ymkn/minimap/image/README.md

# 恒久的な画像

公開用写真、レイアウト図、組立説明図など、継続して参照する画像を置く。作業時のスクリーンショット・レビュー画像は `archive/image/` へ保管し、ここには置かない。現在、恒久画像は未登録。
