ymkn/minimap/FreeCAD/concepts/picture-frame/preview-top.png

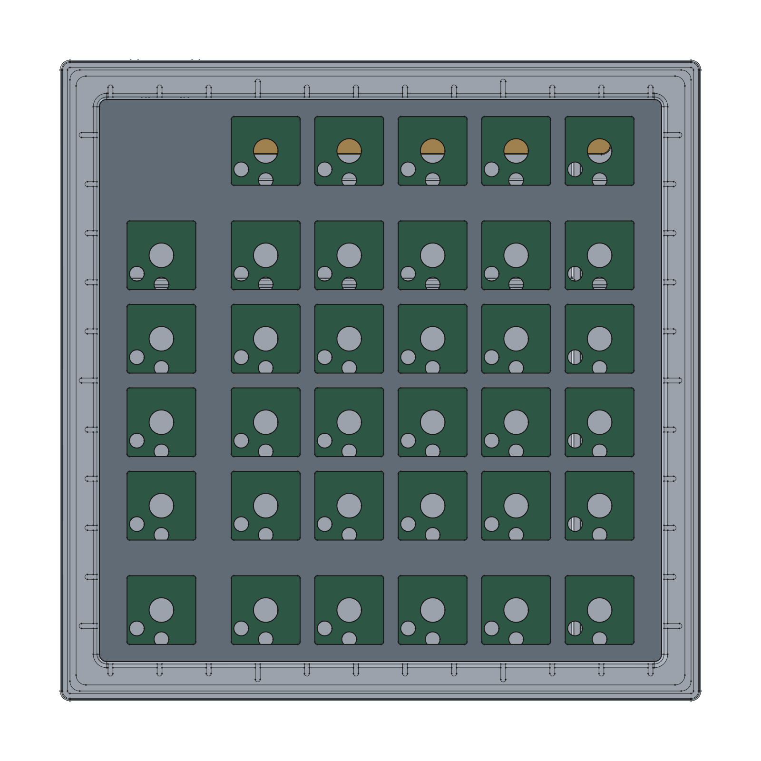
FreeCAD/concepts/picture-frame/preview-top.png
