ymkn/minimap/FreeCAD/concepts/picture-frame/minimap_frame_case.step

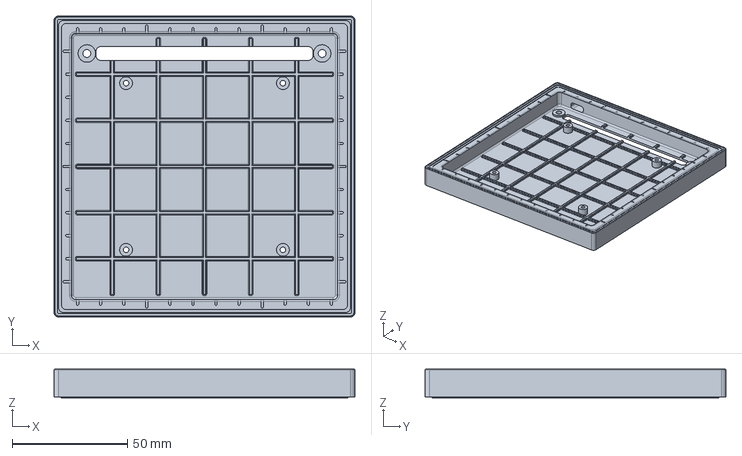
[picture p3: CAD file, 2026-11-08]
FreeCAD/concepts/picture-frame/minimap_frame_case.step
130.5 x 130.5 x 12.4 mm
