ymkn/minimap/FreeCAD/minimap.FCStd

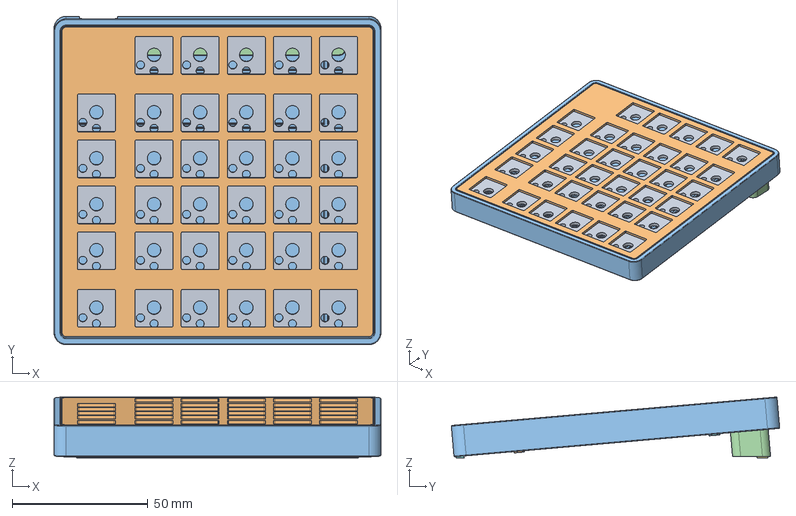
[picture p4: CAD file, 2026-11-03]
FreeCAD/minimap.FCStd
120.5 x 121.0 x 22.4 mm
Bare PCB reference - nominal 1.6mm
Choc plate reference - legacy Z10.4, actual seating UNVERIFIED
MP1 nominal M2 nut - thread omitted
MP2 nominal M2 nut - thread omitted
MP3 nominal M2 nut - thread omitted
MP4 nominal M2 nut - thread omitted
PCB M2x8 D4/H0.5 reference - 1.5mm engagement UNVERIFIED
PCB M2x8 D4/H0.5 reference - 1.5mm engagement UNVERIFIED001
PCB M2x8 D4/H0.5 reference - 1.5mm engagement UNVERIFIED002
PCB M2x8 D4/H0.5 reference - 1.5mm engagement UNVERIFIED003
Case - narrow rear opening / all original PCB mounts retained
Rear metal strip - nominal M3 taps
M3x6 D5.5/H2 low-head envelope - UNVERIFIED
M3x6 D5.5/H2 low-head envelope - UNVERIFIED001
2x rear 10x4x0.6mm rubber reference pads
104x3mm tapered elastomer reference - case front edge support
