ymkn/minimap/FreeCAD/STEP/minimap_weight_metal.step

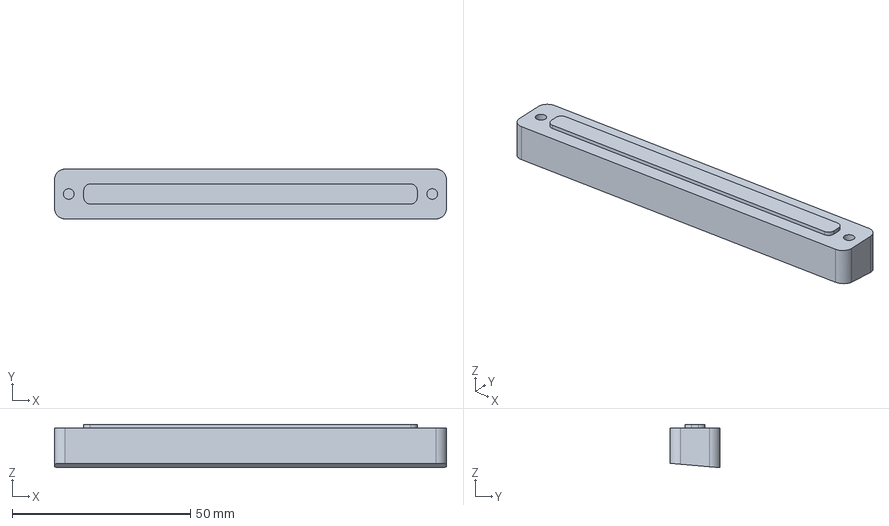
[picture p7: CAD file, 2026-11-03]
FreeCAD/STEP/minimap_weight_metal.step
110.0 x 14.0 x 12.2 mm
