ymkn/minimap/FreeCAD/STEP/minimap_case.step

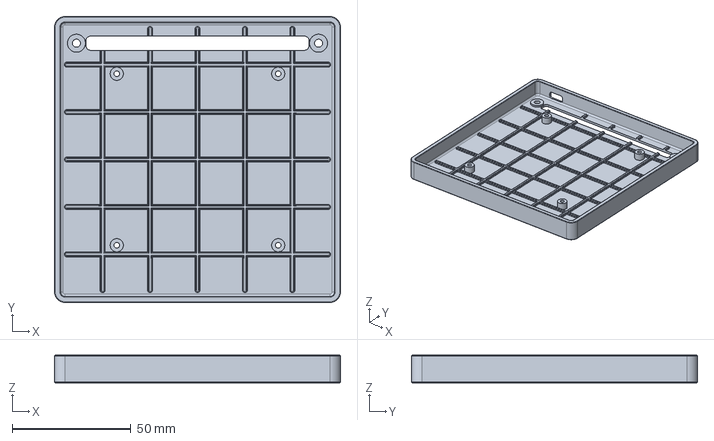
[picture p8: CAD file, 2026-11-03]
FreeCAD/STEP/minimap_case.step
120.5 x 120.5 x 11.6 mm
