ymkn/minimap/KiCAD/PCB_GLP/minimap_PCB.kicad_pcb

## KiCad design KiCAD/PCB_GLP/minimap_PCB.kicad_pcb (2026-11-03)

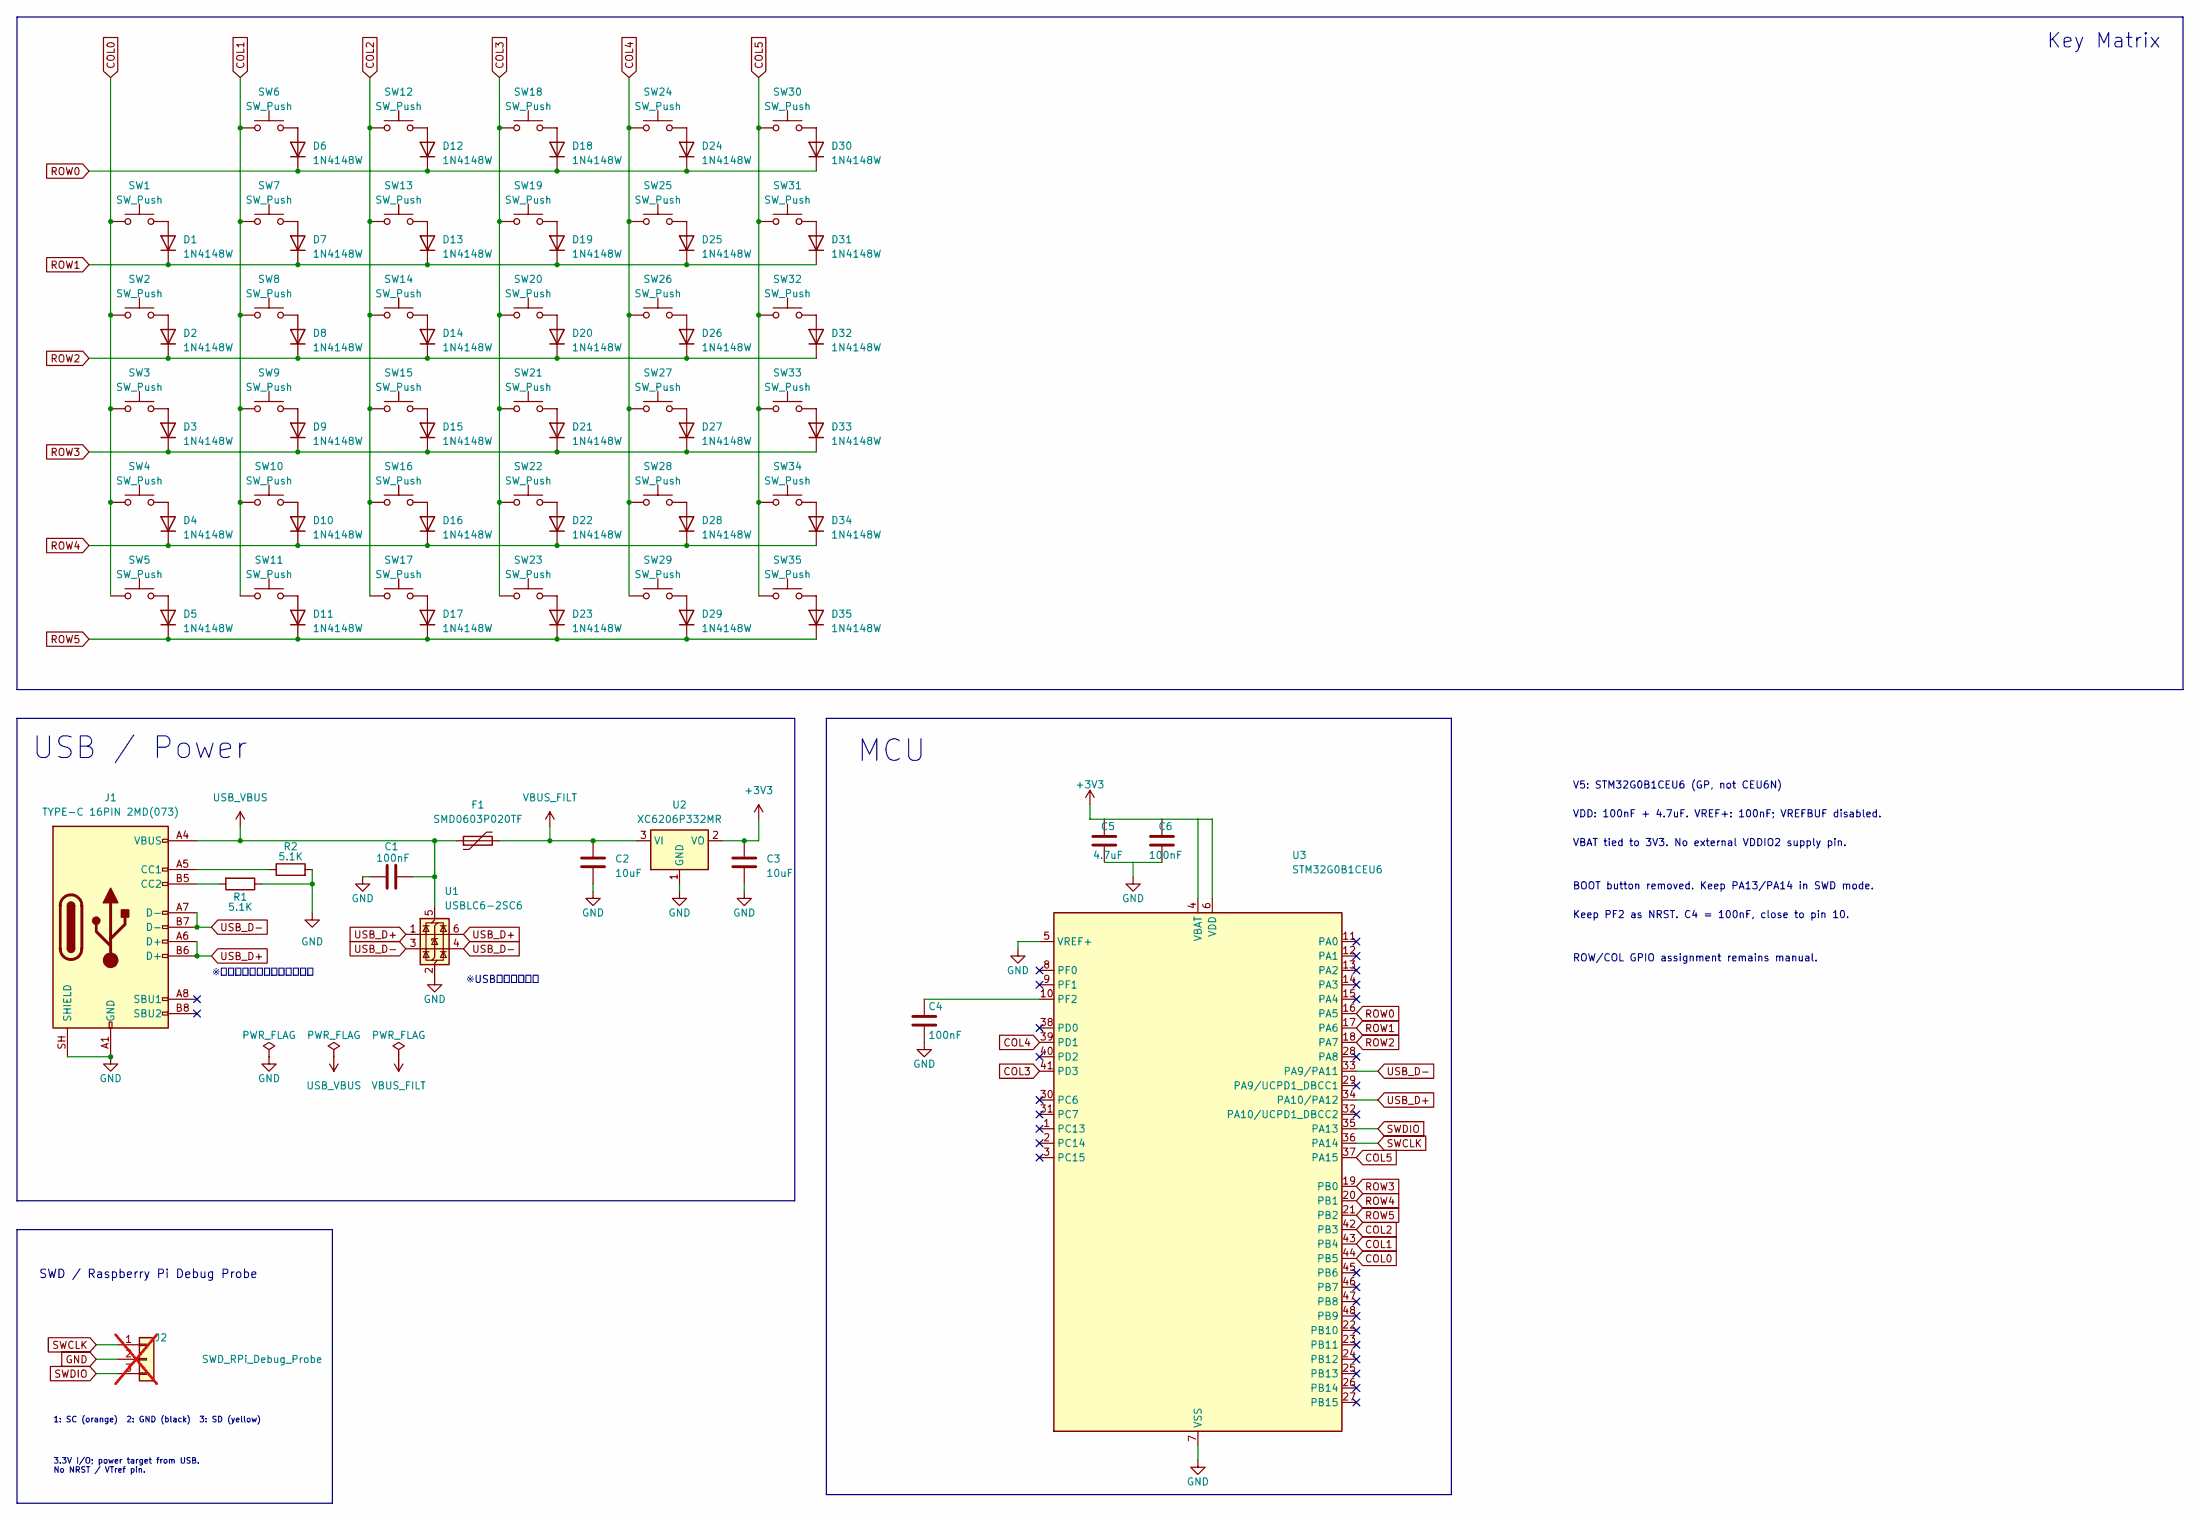
[picture p9: schematic minimap_PCB.kicad_sch, minimap - wired keyboard]

Parts:
C1, C4, C6: 100nF; C_0402_1005Metric; JLCPCB Part # C1525
C2, C3: 10uF; C_0603_1608Metric; JLCPCB Part # C19702
C5: 4.7uF; C_0402_1005Metric; JLCPCB Part # C23733
D1, D2, D3, D4, D5, D6, D7, D8, D9, D10, D11, D12, D13, D14, D15, D16, D17, D18, D19, D20, D21, D22, D23, D24, D25, D26, D27, D28, D29, D30, D31, D32, D33, D34, D35: 1N4148W; D_SOD-123; LCSC Parts # C81598
F1: SMD0603P020TF; Fuse_0603_1608Metric; JLCPCB Part # C20785
J1: TYPE-C 16PIN 2MD(073); USB_C_Receptacle_HRO_TYPE-C-31-M-12; JLCPCB Part # C2765186
J2: SWD_RPi_Debug_Probe; SWD_1x03_PlatedHoles_P2.54mm_D1.0mm; not fitted
R1, R2: 5.1K; R_0402_1005Metric; JLCPCB Part # C25905
SW1, SW2, SW3, SW4, SW5, SW6, SW7, SW8, SW9, SW10, SW11, SW12, SW13, SW14, SW15, SW16, SW17, SW18, SW19, SW20, SW21, SW22, SW23, SW24, SW25, SW26, SW27, SW28, SW29, SW30, SW31, SW32, SW33, SW34, SW35: SW_Push; SW_MX_GLP3_1u; LCSC Parts # C5333465
U1: USBLC6-2SC6; SOT-23-6; JLCPCB Part # C7519
U2: XC6206P332MR; SOT-23-3; JLCPCB Part # C5446
U3: STM32G0B1CEU6; QFN-48-1EP_7x7mm_P0.5mm_EP5.6x5.6mm; JLCPCB Part # C2829190

Connections:
+3V3: C3.1, C5.1, C6.1, U2.2 (VO), U3.4 (VBAT), U3.6 (VDD)
COL0: SW1.1, SW2.1, SW3.1, SW4.1, SW5.1, U3.44 (PB5)
COL1: SW6.1, SW7.1, SW8.1, SW9.1, SW10.1, SW11.1, U3.43 (PB4)
COL2: SW12.1, SW13.1, SW14.1, SW15.1, SW16.1, SW17.1, U3.42 (PB3)
COL3: SW18.1, SW19.1, SW20.1, SW21.1, SW22.1, SW23.1, U3.41 (PD3)
COL4: SW24.1, SW25.1, SW26.1, SW27.1, SW28.1, SW29.1, U3.39 (PD1)
COL5: SW30.1, SW31.1, SW32.1, SW33.1, SW34.1, SW35.1, U3.37 (PA15)
GND: C1.2, C2.2, C3.2, C4.2, C5.2, C6.2, J1.A1 (GND), J1.A12 (GND), J1.B1 (GND), J1.B12 (GND), J1.SH (SHIELD), J2.2, R1.1, R2.2, U1.2 (GND), U2.1 (GND), U3.5 (VREF+), U3.7 (VSS), U3.49 (VSS)
unnamed: D1.2 (A), SW1.2
unnamed: D2.2 (A), SW2.2
unnamed: D3.2 (A), SW3.2
unnamed: D4.2 (A), SW4.2
unnamed: D5.2 (A), SW5.2
unnamed: D6.2 (A), SW6.2
unnamed: D7.2 (A), SW7.2
unnamed: D8.2 (A), SW8.2
unnamed: D9.2 (A), SW9.2
unnamed: D10.2 (A), SW10.2
unnamed: D11.2 (A), SW11.2
unnamed: D12.2 (A), SW12.2
unnamed: D13.2 (A), SW13.2
unnamed: D14.2 (A), SW14.2
unnamed: D15.2 (A), SW15.2
unnamed: D16.2 (A), SW16.2
unnamed: D17.2 (A), SW17.2
unnamed: D18.2 (A), SW18.2
unnamed: D19.2 (A), SW19.2
unnamed: D20.2 (A), SW20.2
unnamed: D21.2 (A), SW21.2
unnamed: D22.2 (A), SW22.2
unnamed: D23.2 (A), SW23.2
unnamed: D24.2 (A), SW24.2
unnamed: D25.2 (A), SW25.2
unnamed: D26.2 (A), SW26.2
unnamed: D27.2 (A), SW27.2
unnamed: D28.2 (A), SW28.2
unnamed: D29.2 (A), SW29.2
unnamed: D30.2 (A), SW30.2
unnamed: D31.2 (A), SW31.2
unnamed: D32.2 (A), SW32.2
unnamed: D33.2 (A), SW33.2
unnamed: D34.2 (A), SW34.2
unnamed: D35.2 (A), SW35.2
unnamed: J1.A5 (CC1), R2.1
unnamed: J1.B5 (CC2), R1.2
unnamed: C4.1, U3.10 (PF2)
ROW0: D6.1 (K), D12.1 (K), D18.1 (K), D24.1 (K), D30.1 (K), U3.16 (PA5)
ROW1: D1.1 (K), D7.1 (K), D13.1 (K), D19.1 (K), D25.1 (K), D31.1 (K), U3.17 (PA6)
ROW2: D2.1 (K), D8.1 (K), D14.1 (K), D20.1 (K), D26.1 (K), D32.1 (K), U3.18 (PA7)
ROW3: D3.1 (K), D9.1 (K), D15.1 (K), D21.1 (K), D27.1 (K), D33.1 (K), U3.19 (PB0)
ROW4: D4.1 (K), D10.1 (K), D16.1 (K), D22.1 (K), D28.1 (K), D34.1 (K), U3.20 (PB1)
ROW5: D5.1 (K), D11.1 (K), D17.1 (K), D23.1 (K), D29.1 (K), D35.1 (K), U3.21 (PB2)
SWCLK: J2.1, U3.36 (PA14)
SWDIO: J2.3, U3.35 (PA13)
USB_D+: J1.A6 (D+), J1.B6 (D+), U1.1 (I/O1), U1.6 (I/O1), U3.34 (PA10/PA12)
USB_D-: J1.A7 (D-), J1.B7 (D-), U1.3 (I/O2), U1.4 (I/O2), U3.33 (PA9/PA11)
USB_VBUS: C1.1, F1.1, J1.A4 (VBUS), J1.A9 (VBUS), J1.B4 (VBUS), J1.B9 (VBUS), U1.5 (VBUS)
VBUS_FILT: C2.1, F1.2, U2.3 (VI)

Notes on the sheet:
MCU
SWD / Raspberry Pi Debug Probe
BOOT button removed. Keep PA13/PA14 in SWD mode.
1: SC (orange) 2: GND (black) 3: SD (yellow)
※USBコネクタ近傍
Keep PF2 as NRST. C4 = 100nF, close to pin 10.
3.3V I/O; power target from USB. No NRST / VTref pin.
※差動信号、配線長さ合わせる
ROW/COL GPIO assignment remains manual.
Key Matrix
V5: STM32G0B1CEU6 (GP, not CEU6N)
VBAT tied to 3V3. No external VDDIO2 supply pin.
USB / Power
VDD: 100nF + 4.7uF. VREF+: 100nF; VREFBUF disabled.

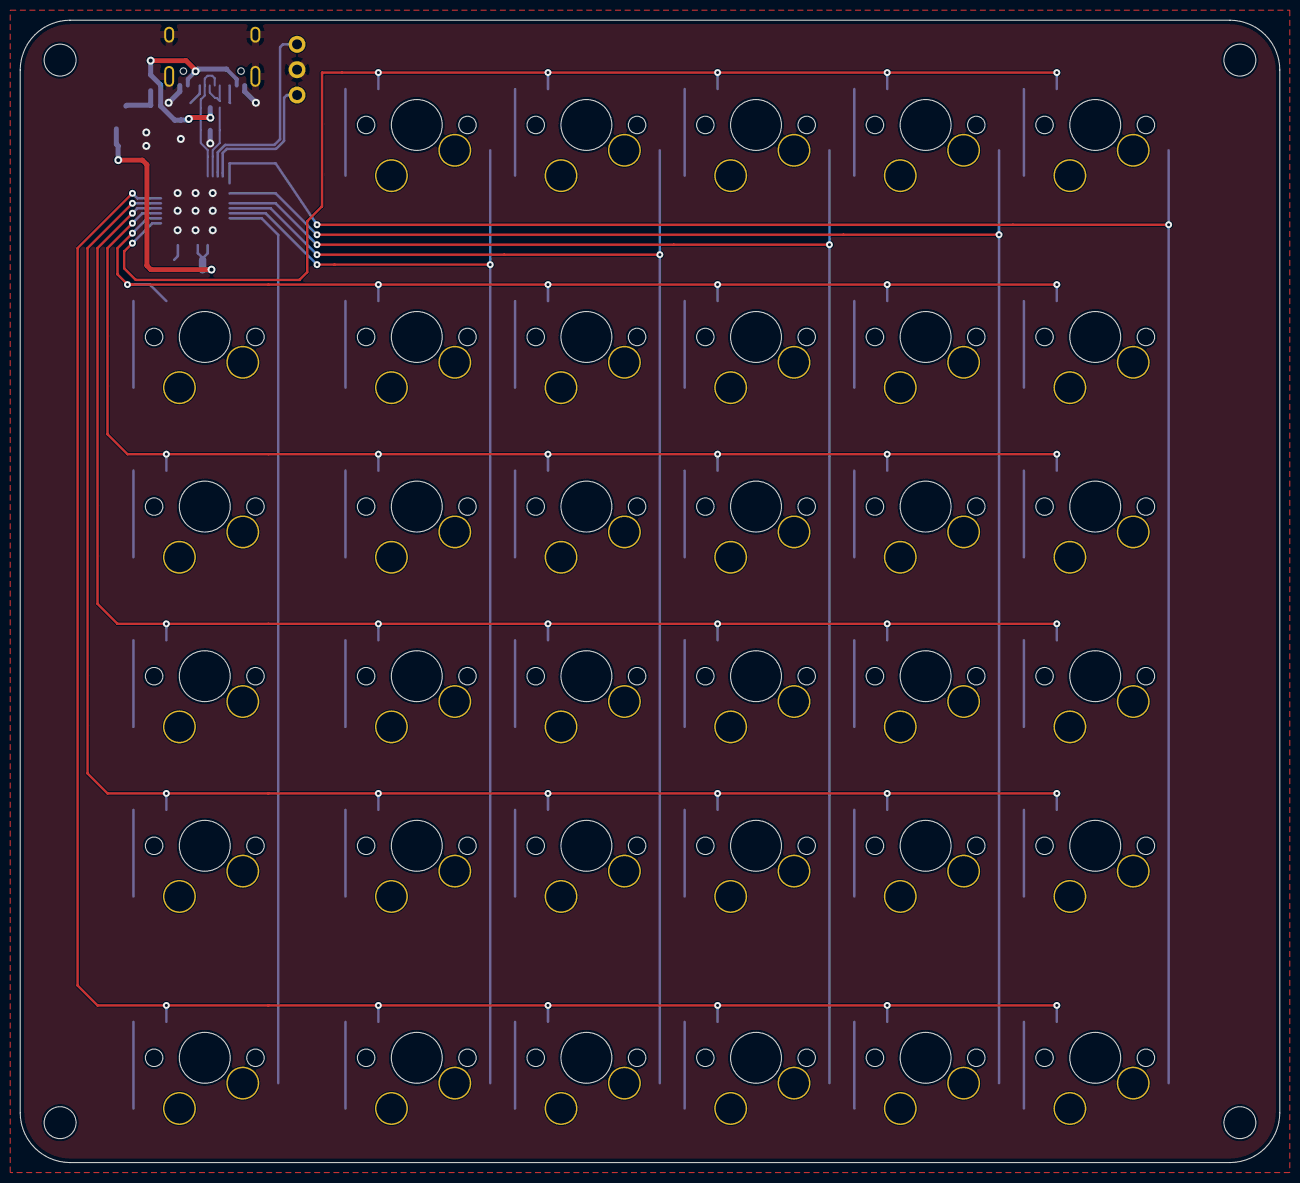
[picture p10: board minimap_PCB.kicad_pcb from above]

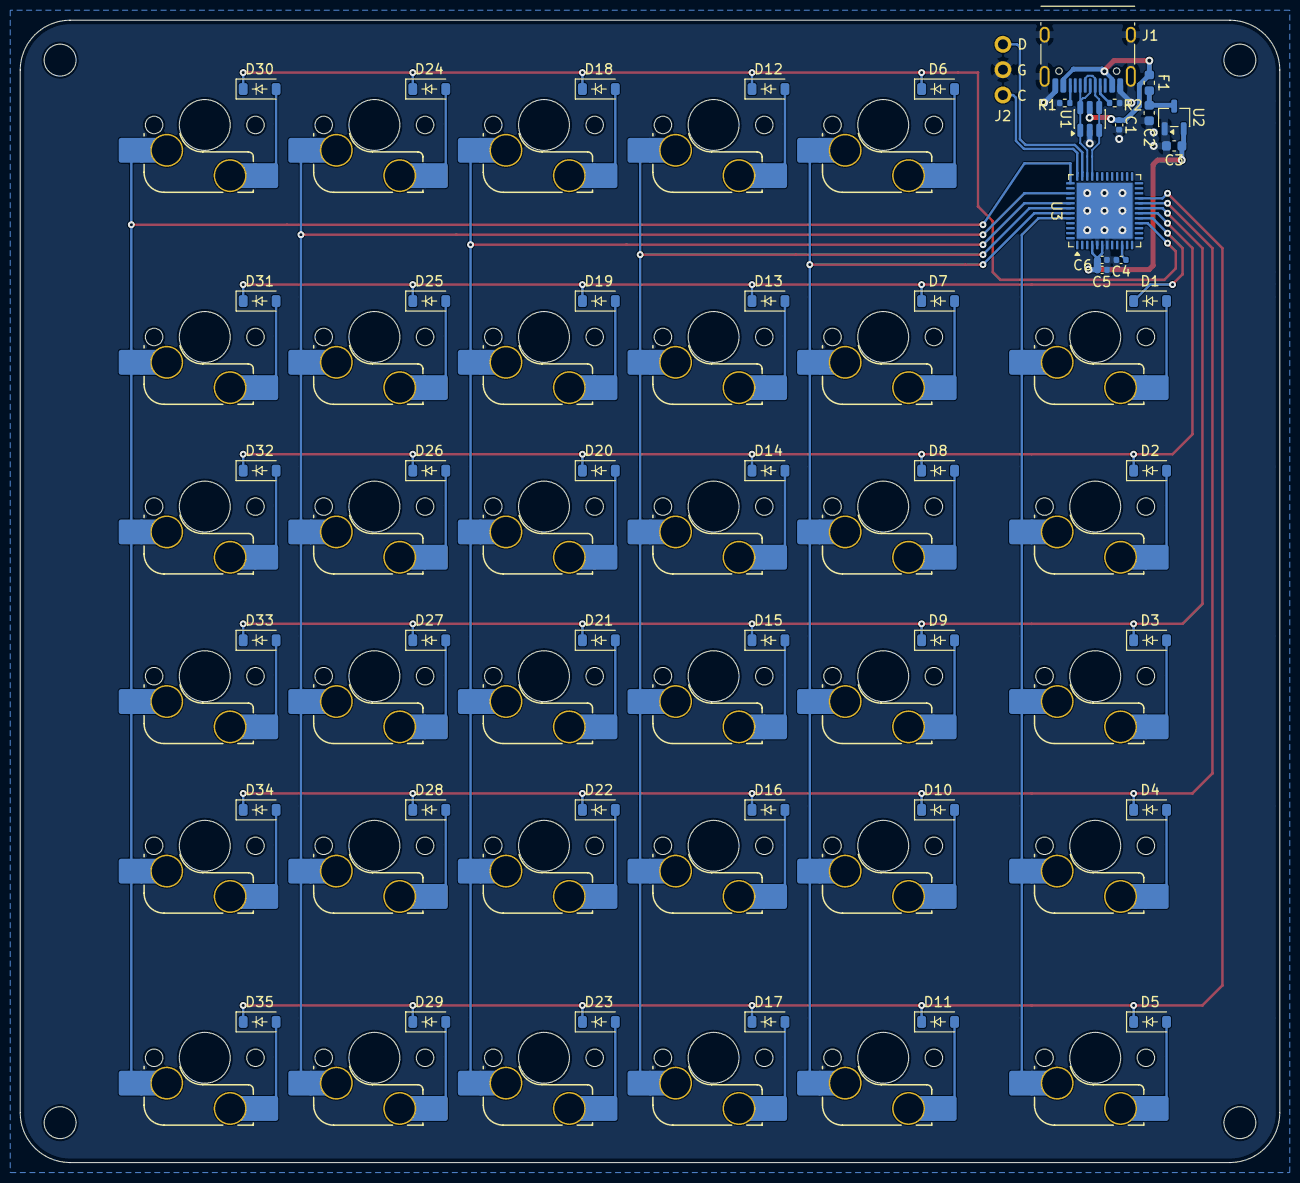
[picture p11: board minimap_PCB.kicad_pcb from below]

Board: 2 copper layers, 126.2 x 114.5 mm, 88 parts (84 on the bottom side), 58 nets.

Other parts of the board:
H_MOUNT1, H_MOUNT2, H_MOUNT3, H_MOUNT4: MountingHole_DampingBall_D3.2mm
